NathalieAlomari-ai/AMR-Warehouse-System/ros2_ws/frames_2026-06-13_13.51.03.pdf

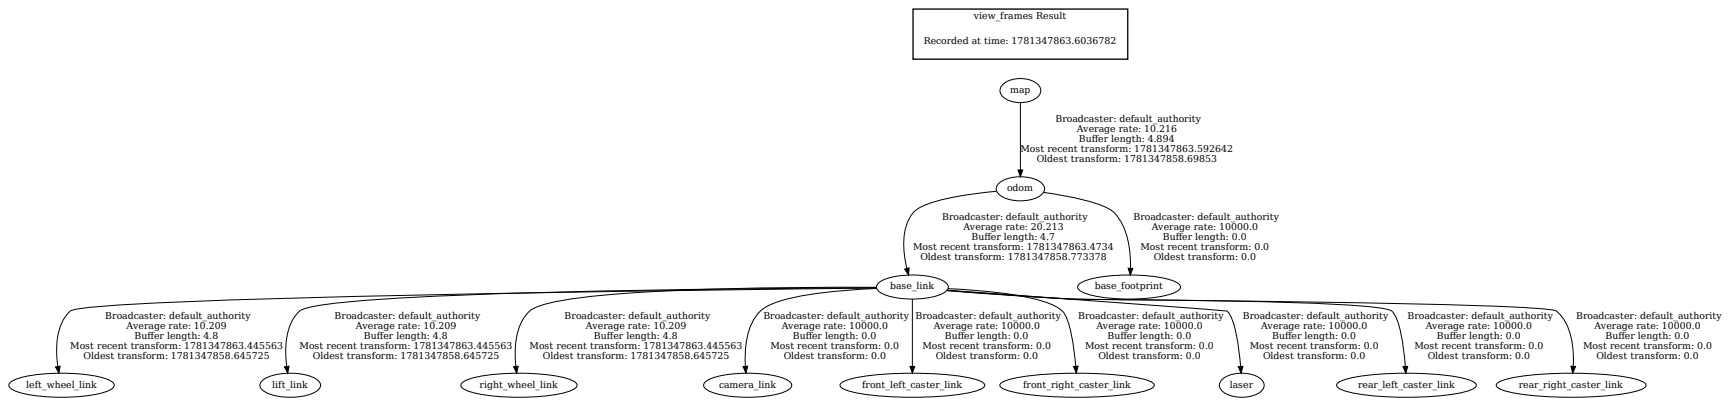
[picture p1: page 1]
view_frames Result; map; odom; Broadcaster: default_authority Average rate: 10.216 Buffer length: 4.894; base_link; Broadcaster: default_authority Average rate: 20.213 Buffer length: 4.7; base_footprint; left_wheel_link; Broadcaster: default_authority Average rate: 10.209 Buffer length: 4.8; lift_link; right_wheel_link; camera_link; front_left_caster_link; front_right_caster_link; laser; rear_left_caster_link; rear_right_caster_link

Recorded at time: 1781347863.6036782

Most recent transform: 1781347863.592642
Oldest transform: 1781347858.69853

Broadcaster: default_authority
Average rate: 10000.0
Buffer length: 0.0
Most recent transform: 0.0
Oldest transform: 0.0

Most recent transform: 1781347863.4734
Oldest transform: 1781347858.773378

Most recent transform: 1781347863.445563
Oldest transform: 1781347858.645725
