NathalieAlomari-ai/AMR-Warehouse-System/ros2_ws/src/amr_navigation/config/mapper_params_online_async.yaml

slam_toolbox:
  ros__parameters:

    # -----------------------------------------------------------------
    # Frames  — must match the URDF link names
    # -----------------------------------------------------------------
    odom_frame:  odom
    map_frame:   map
    base_frame:  base_footprint
    scan_topic:  /scan

    # -----------------------------------------------------------------
    # Mode
    # -----------------------------------------------------------------
    mode:         mapping
    use_sim_time: false

    # -----------------------------------------------------------------
    # Map update / TF
    # -----------------------------------------------------------------
    debug_logging:            false
    throttle_scans:           1
    transform_publish_period: 0.02   # seconds; 0 = never
    map_update_interval:      5.0    # seconds between full map updates
    resolution:               0.05   # metres per cell
    minimum_laser_range:      0.15   # metres — SLLIDAR C1 min range is 0.1 m
    max_laser_range:          12.0   # metres — SLLIDAR C1 max range
    minimum_time_interval:    0.1
    transform_timeout:        0.2
    tf_buffer_duration:       30.0
    stack_size_to_use:        40000000
    enable_interactive_mode:  true

    # -----------------------------------------------------------------
    # Scan matching
    # -----------------------------------------------------------------
    use_scan_matching:               true
    use_scan_barycenter:             true
    minimum_travel_distance:         0.1
    minimum_travel_heading:          0.1
    scan_buffer_size:                10
    scan_buffer_maximum_scan_distance: 10.0
    link_match_minimum_response_fine:  0.1
    link_scan_maximum_distance:        1.5
    loop_search_maximum_distance:      3.0
    do_loop_closing:                   true
    loop_match_minimum_chain_size:     10
    loop_match_maximum_variance_coarse:   3.0
    loop_match_minimum_response_coarse:   0.35
    loop_match_minimum_response_fine:     0.45

    # -----------------------------------------------------------------
    # Correlation search (translation)
    # -----------------------------------------------------------------
    correlation_search_space_dimension:       0.5
    correlation_search_space_resolution:      0.01
    correlation_search_space_smear_deviation: 0.1

    # -----------------------------------------------------------------
    # Correlation search (loop closure)
    # -----------------------------------------------------------------
    loop_search_space_dimension:       8.0
    loop_search_space_resolution:      0.05
    loop_search_space_smear_deviation: 0.03

    # -----------------------------------------------------------------
    # Scan matcher penalties
    # -----------------------------------------------------------------
    distance_variance_penalty:  0.5
    angle_variance_penalty:     1.0
    fine_search_angle_offset:   0.00349   # ~0.2 deg
    coarse_search_angle_offset: 0.349     # ~20 deg
    coarse_angle_resolution:    0.0349    # ~2 deg
    minimum_angle_penalty:      0.9
    minimum_distance_penalty:   0.5
    use_response_expansion:     true
