NathalieAlomari-ai/AMR-Warehouse-System/(commit log)

2026-05-23 Add SLAM launch file
    [amr_robot.urdf.xacro]
2026-05-29 wheels testing open loop 40% (100 pwm)
2026-05-29 Update serial bridge node to read Odometry data for SLAM
2026-05-30 Added PID with ros2 linkage
2026-05-31 fixed imu address
2026-05-31 pid best values for no load <0.50,0.0>
2026-06-12 Add YOLOv8n Colab training notebook (Task 3)
    Full training notebook with:
    - GPU check, ultralytics install, Drive mount + dataset extraction
    - data.yaml path fix for Colab absolute paths
    - YOLOv8n fine-tuning with warehouse-specific augmentation
    (hsv_v=0.6 for dim lighting, degrees=5 for camera tilt)
    - Validation with per-class mAP50 breakdown
    - Test inference visualization
    - Auto-save best.pt to Drive + direct laptop download
2026-06-13 feat: migrate firmware source files to correct directory and integrate ROS 2 serial bridge
    [Config.h, DriveSystem.h, MotorController.h, MotorDriver.h, PIDController.h, main.cpp, serial_bridge_node.py]
2026-06-13 refactor: reorganize project structure into modules (bringup, description, navigation, hardware) and integrate slam_toolbox
    [amr_robot.urdf.xacro]
2026-06-13 fix: align frame_id to 'laser' across launch and URDF
    [amr_robot.urdf.xacro]
2026-06-13 fix: set robot joints to fixed for stable presentation mode
    [amr_robot.urdf.xacro]
2026-06-13 fix: align serial bridge with firmware V-packet protocol
    [serial_bridge_node.py]
2026-06-13 Add full modular vision pipeline (Tasks 4, 5, 9)
    Modules added to amr_vision/:
    - camera_utils.py : AstraCamera wrapper (OpenNI2 + OpenCV)
    - depth_utils.py : DepthSampler (10x10 patch avg + rolling median buffer)
    - qr_detector.py : YOLO + pyzbar QR with 5-frame confirm threshold
    - barcode_detector.py: YOLO + pyzbar barcode with SKU check + depth anchor
    - visual_servo.py : proportional controller with hysteresis (enter=10px, exit=25px)
    - vision_main.py : 3-stage state machine (STAGE_1->2->3->GRIP->DONE)
    - teensy_comm.py : ASCII serial protocol to Teensy 4.1
    Scripts:
    - test_model.py: quick sanity check for best.pt on Astra Pro RGB stream
    Each module has a standalone __main__ t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
2026-06-14 Add box_detector.py and two-phase servo alignment in Stage 3
    - box_detector.py: detects class 0 (cardboard box) with depth sampling
    over a 20px patch for stable distance readings
    - vision_main.py Stage 3 updated:
    COARSE phase: box centre as servo anchor (large, visible when misaligned)
    FINE phase: barcode centre as anchor once box roughly centred
    Aligned only declared when barcode is the anchor (precise) + offset < 10px
    This solves the problem of barcode being too small to detect reliably
    when the robot is far or laterally misaligned.
    [box_detector.py, vision_main.py]
2026-06-16 Replace barcode with QR for Stage 2+3 FINE alignment; lower box confidence to 0.25
    [box_detector.py, vision_main.py]
2026-06-19 Fix: motor polarity, odometry ticks_per_rev, and TF frame tree
    [amr_robot.urdf.xacro]
2026-06-19 fix: harden serial telemetry parsing against corrupted lines
    Add header and field-count guards so garbled packets (e.g. from
    noisy USB-serial) are dropped before any type conversion. Move
    the fields dict build inside the try-except and broaden the handler
    to Exception so no parse error can propagate to the caller.
    [serial_bridge_node.py]
2026-06-21 trying pid with abdualla
2026-06-21 Fix: Calibrate encoder PPR to 2700 and fine-tune PID gains for stable differential drive
    [Config.h, DriveSystem.h, MotorController.h, PIDController.h, serial_bridge_node.py]
2026-06-22 fix: Configure BNO055 to IMUPLUS mode and update encoder PPR to 2700
    [Config.h]
2026-06-22 fix the serial brridge node
    [serial_bridge_node.py]
2026-06-22 fix number 2 is serial bridge
    [serial_bridge_node.py]
2026-06-23 fix the 2700 in ros2
    [amr_robot.urdf.xacro]
2026-06-23 fix: update PID VEL_KI to 1.0 to eliminate steady-state error
    [Config.h, main.cpp, mapper_params_online_async.yaml]
2026-06-23 fix: remove 180° yaw rotation from base_footprint_joint
    The rpy="0 0 3.14159" was flipping the robot 180° causing it to appear
    moving backward in RViz while physically moving forward.
    Claude-Session: https://claude.ai/code/session_01398Y6ZFw1hy4skUhHrX21f
    [amr_robot.urdf.xacro]
2026-06-23 fix: change wheel joints from fixed to continuous for live odometry
    Wheels were defined as fixed joints (presentation mode), preventing
    ROS from tracking wheel rotation. Now continuous with Y-axis rotation
    so encoder odometry and SLAM work correctly on real hardware.
    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
    [amr_robot.urdf.xacro]
2026-06-23 fix: add joint_state_publisher to bringup for continuous wheel joints
    Wheel joints changed to continuous require joint state messages for
    robot_state_publisher to broadcast their TF frames. Without this node
    the TF tree was incomplete causing warnings that could affect SLAM.
    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
2026-06-24 fix: move lidar and camera to rear of robot base_link
    Relocate laser joint from X=+0.25 to X=-0.25 and camera joint from
    X=+0.32 to X=-0.32, rotating camera 180° to face rearward (-X).
    [amr_robot.urdf.xacro]
2026-06-25 fix: close the velocity control loop using encoder PID feedback
    MotorController was open-loop — both motors received identical PWM
    regardless of actual speed, causing the robot to veer after ~2 s due
    to per-motor friction and back-EMF differences.
    Now update() reads the encoder every 20 ms, computes RPM, and runs
    PIDController (Kp/Ki from Config.h) to correct PWM until actual RPM
    matches the target. The integrator resets on stop to prevent windup
    carrying into the next move.
    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
    [MotorController.h]
2026-06-25 fix: swap left encoder pins to match forward=positive convention
    Left encoder was reading negative RPM while moving forward, causing
    the closed-loop PID to fight itself (setpoint=+50, actual=-50,
    error=+100 → diverges). Swapping pins 22/23 makes both encoders
    read positive when the robot moves forward, consistent with the
    positive RPM commands sent by serial_bridge_node.
    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
    [main.cpp]
2026-06-25 fix: add motor inversion, feed-forward, and correct odometry sign
    Four bugs on this branch were causing the robot to veer / fail to drive:
    1. Left motor drove backward: the encoder pin swap (23,22) fixed the encoder
    reading direction but setSpeed(+duty) still activated RPWM = backward for
    the left BTS7960. Added motorInverted=true so duty is negated before
    setSpeed(), activating LPWM = left forward.
    2. No feed-forward: PIDController was pure P+I+D → duty with no baseline.
    Without FF the integrator had to wind up from zero before the motor moved,
    and VEL_ICLAMP=200 wound up so high that stopping failed (integral fought
    the deceleration ramp). Added ffDuty = targetRPM/m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
    [Config.h, MotorController.h, main.cpp, serial_bridge_node.py]
2026-06-25 fix: normalise left encoder delta and encoder count in firmware
    The encoder pin swap (23,22) did not reverse the raw count direction —
    left encoder still increments negative for forward motion on real hardware.
    Without delta normalisation the PID saw target=+80, actual=-128 → error=+208
    → max duty, making the left motor run at free-run max (~130 RPM) while
    the right motor was PID-controlled to 78 RPM. The robot veered hard left.
    Changes:
    - inverted flag now negates rawDelta before PID and telem accumulation,
    so _actualRPM and _telemRPM are +positive for forward on both motors.
    - getEncoderCount() returns -_lastCount when inverted so DriveSystem's
    simple (left + right) sum gives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
    [MotorController.h, main.cpp]
2026-06-25 feat(web_app): add Navixa dashboard + landing page + skills
    [angular.csv, app-interface.csv, astro.csv, charts.csv, colors.csv, design.csv, draft.csv, flutter.csv]
2026-06-25 final code fixed with robot moving in stright line
    [Config.h, MotorController.h, main.cpp]
2026-06-25 fix: serial_bridge owns odom TF to fix slam_toolbox message filter timing
2026-06-25 fix: set minimum_laser_range 0.15m and transform_timeout 0.5s for SLLIDAR C1
    [mapper_params_online_async.yaml]
2026-06-28 dark mode + removing sutitle in home + rename lidar
2026-06-29 feat: wire up Nav2 autonomous navigation bringup
2026-06-30 Jetson migration: config.py platform detection, QR multi-decode, servo rate limiting
2026-07-01 feat: add waypoint saver and navigator scripts for warehouse missions
    - waypoint_saver.py: saves current AMCL pose as a named waypoint to waypoints.yaml
    - waypoint_navigator.py: sends robot to any named waypoint via Nav2 action
    - waypoints.yaml: empty waypoints config, populated by waypoint_saver
    - CMakeLists: install scripts to lib/ so ros2 run works
    - package.xml: add rclpy, nav2_msgs, geometry_msgs dependencies
2026-07-02 fix: flip drive direction so LiDAR side is robot front
    - URDF: rotate base_footprint_joint 180 deg around Z so LiDAR appears at +X
    - serial_bridge: add flip_drive_direction param; negates linear cmd to Teensy
    and negates measured vx so forward = LiDAR-first throughout the stack
    - bringup: enable flip_drive_direction=True for physical robot
    This fixes backwards navigation in Nav2 and removes the zig-zag caused
    by the 180-degree frame mismatch between URDF and physical robot.
    [amr_robot.urdf.xacro]
2026-07-02 fix: correct URDF wheel/caster positions to match physical robot layout
    After the 180-degree base_footprint flip, wheel_x must be positive so
    drive wheels appear behind centre (toward caster/back side) in RViz.
    Rear casters repositioned to x=+0.10 so all 4 casters appear at the
    back of the robot in the flipped frame, matching physical hardware.
    [amr_robot.urdf.xacro]
2026-07-05 Allow DWB to command reverse velocity so robot can back out of blocked spots
2026-07-05 Tighten inflation radius/scaling to stop DWB refusing narrow aisles
2026-07-05 Fix MQTT topics to match web app contract (amr/status, amr/orders)
    [mqtt_publisher.py, vision_main.py]
2026-07-07 Add aux-hardware bridge, mission coordinator, and vision stub
    Integrate lift/stepper/pump/vision onto the single Teensy via one serial
    owner. serial_bridge_node gains /aux/command (verbatim passthrough) and
    /aux/status (routes Teensy EVT lines); odometry path untouched.
    New amr_coordinator package:
    - coordinator_node.py: plain async FSM sequencing the full pick-and-place
    mission (Nav2 -> shelf QR -> lift -> box QR + centering -> grip -> drop
    -> home), blocking on EVT acks, aborting to STOP on fault/timeout.
    - vision_stub.py: answers /vision/request and streams SERVO so the mission
    runs without the YOLO camera pipeline.
    Hand-off docs for the firmware port (pin map + non-blocking parse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
2026-07-07 Add lift control to the unified integration firmware
    Ports the bench-tested linear actuator onto the same Teensy 4.1 that
    runs drive PID + odometry, since serial_bridge_node requires a single
    serial owner. Implements LIFT <mm>/STOP per docs/HANDOFF_zahra_firmware.md,
    tracking estimated position by delta rather than absolute duration so
    repeated partial moves (e.g. 200 -> 0 -> 120) don't mis-time. Only a
    bottom re-homing switch is wired — the top limit switch was dropped
    after bench-verifying full-range timing on the assembled scissor lift.
    Stepper carriage and vacuum pump are intentionally not ported yet.
2026-07-09 Calibrate lift actuator speed/travel from bench tests (integration: wheels + linear actuator only, no upper mechanism yet)
    Bench-measured the assembled scissor lift under its ~10kg working load
    and corrected several bad assumptions in the open-loop lift timing:
    - True actuator rod travel is 0-444mm, not the originally assumed 500mm
    (confirmed by running the bare actuator off a power supply). Lowered
    LIFT_MAX_TRAVEL_MM to 434mm (10mm margin, no hardware backup since
    there's no top switch).
    - Split the single ACTUATOR_SPEED_MM_S into direction-specific
    ACTUATOR_EXTEND_SPEED_MM_S / ACTUATOR_RETRACT_SPEED_MM_S, since the
    load makes retracting (gravity-assisted) faster than extending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
    [Config.h, LiftControl.h]
2026-07-09 integration node with natalie and zahra command + smooth centering for my part + cmd_vel remove accidental web_app/skills tree
    [angular.csv, app-interface.csv, astro.csv, charts.csv, colors.csv, design.csv, draft.csv, flutter.csv]
2026-07-11 Pull Abdalla's real vision package to replace the integration stub
    Replaces the placeholder pretrained.py/visualloop.py with the actual
    QR/barcode/box detection pipeline from abdalla-vision-branch, including
    the ROS-based teensy_comm.py (publishes to /aux/command instead of
    opening serial directly, per docs/HANDOFF_abdalla_vision.md) so it can
    run alongside serial_bridge_node on the integrated robot.
    [barcode_detector.py, box_detector.py, camera_utils.py, config.py, depth_utils.py, mqtt_publisher.py, qr_detector.py]
2026-07-11 Detect --break-system-packages support in setup_jetson.sh instead of assuming it
    pip 22.0.2 (stock on Ubuntu 22.04, confirmed on the Jetson) predates
    PEP 668 and doesn't recognize --break-system-packages at all -- passing
    it made every pip3 install call in the script fail outright. Only add
    the flag when the installed pip actually supports it.
2026-07-11 Fix setup_jetson.sh: no prebuilt Jetson torchvision, and pip clobbers torch
    Two real bugs found while deploying to the Jetson:
    1. NVIDIA doesn't publish a prebuilt torchvision wheel for Jetson (only
    pytorch/ and tensorflow/ exist under their v## redist folders) --
    torchvision has to be built from source against the installed torch
    build. Document that step, including the gotcha that verifying it
    must happen from outside the source checkout dir (Python otherwise
    shadows the installed package with the uncompiled source tree).
    2. `pip install -r requirements.txt` was letting pip "resolve"
    ultralytics' unpinned `torch>=1.8.0` dependency by silently
    uninstalling the correct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
2026-07-11 Pull Abdalla's mqtt_bridge node for the web dashboard
    Cherry-picked from abdalla-vision-branch (de3d364a673ccd8de649870301846c8ab24ee6b9),
    scoped to just this commit so it doesn't pull in his branch's stale
    setup_jetson.sh over our fixed version.
    Bridges the integrated ROS2 mission to the web dashboard over MQTT:
    watches /mission/state (or infers from /vision/request, /aux/command,
    /cmd_vel) and publishes amr/status, and turns dashboard PICK/STOP
    orders into /mission/start and /aux/command STOP. Self-contained in
    amr_vision, no changes required to the coordinator or other nodes.
    [mqtt_bridge.py, mqtt_publisher.py]
2026-07-12 Add full power/wiring guide and fix stale stepper pin docs
    README's pin map and wiring checklist still referenced the pre-remap
    stepper/relay pins (26/27, 24/25) instead of the actual 36/37/40/41 in
    Config.h. Also adds a full connection guide: power architecture, thick vs
    thin wire gauges by circuit, common grounding, TB6600 DIP switch tables
    (current + microstep), and the common-cathode signal wiring this board
    uses. Code comments in Config.h/StepperControl.h/main.cpp now point to it.
    [Config.h, StepperControl.h, main.cpp]
2026-07-13 camera_utils: fall back to RGB-only when the depth stream can't open
2026-07-13 camera: add DEPTH_ENABLED switch to skip OpenNI2 (avoids segfault when depth sensor unpowered)
    [camera_utils.py, config.py]
2026-07-14 Add headless live_qr_test.py for on-Jetson camera+QR verification
2026-07-17 Fix BOX_QR centring fighting Nav2: route vision through twist_mux (cmd_vel_vision, prio 50)
    [vision_node.py]
2026-07-17 web_app: update team roles (Abdalla: Battery + Vision & Software; Zahra: Lifting & Suction Subsystem)
2026-07-17 Fix drive wheel direction bugs: left encoder A/B swap and right motor polarity
    Bench testing traced the robot rotating in place instead of driving straight
    to two independent wiring issues, not a PID tuning problem:
    - Left encoder was wired A=23/B=22, counting backward; corrected to A=22/B=23
    in the Encoder constructor.
    - Right BTS7960 has RPWM wired as reverse (not forward as originally assumed)
    -- confirmed by watching the right wheel visibly spin backward under a
    positive target. Set motorInverted=true for rightMotor to match, same as
    the already-correct left side.
    Updated README.md pin map and wiring guide to match the corrected wiring.
    [main.cpp]
2026-07-17 Speed up stepper carriage after fixing homing/extend/retract stall margin
    Homing speed (400->1200 SPS) and normal move speed (3200->4200 SPS) raised
    for faster cycle time. Acceleration raised alongside (2400->4200 steps/s^2)
    to keep the same limit-switch stopping distance at the higher cruise speed --
    without it, stop() decelerates over a much longer distance (scales with
    speed^2), so the carriage kept coasting well past the switch instead of
    stopping promptly.
    [Config.h]
2026-07-18 Add laser box filter to drop scissor-lift pillars from /scan
2026-07-18 Fix empty /scan: run chassis box filter in laser frame (no TF dependency)
    [main.cpp]
2026-07-18 Fix serial_bridge ticks_per_rev 1000->2700 to match firmware ENCODER_PPR
    [serial_bridge_node.py]
2026-07-18 Fix TF ownership: EKF owns odom->base_footprint (fused IMU yaw), not serial_bridge
    serial_bridge was publishing a raw wheel-odometry TF (unreliable encoder
    yaw) while the EKF's TF was disabled, discarding the IMU heading fusion.
    AMCL drifted/lost the map on every rotation. Now matches ekf.yaml design.
2026-07-18 Revert serial_bridge ticks_per_rev 2700->1000
    [serial_bridge_node.py]
2026-07-18 fix: restore EKF ownership of odom->base_footprint TF
    Commit 34da2b9 handed the odom->base_footprint transform to
    serial_bridge_node (raw encoder odometry) to silence a slam_toolbox
    message-filter timing warning. This bypassed the EKF, so Nav2/AMCL
    localized off encoder-only heading, which is documented-unreliable
    (gearbox backlash/slip). The result: robot pose drifts/spins in the
    map and AMCL gets lost when navigating to a goal.
    Restore the intended design (matching every comment in bringup.launch.py
    and ekf.yaml): serial_bridge publish_tf=False, ekf_node publish_tf=True,
    so the IMU-fused heading drives the transform Nav2 depends on.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
2026-07-18 fix: correct ticks_per_rev 1000->2700 to match firmware ENCODER_PPR
    serial_bridge_node used ticks_per_rev=1000 while the Teensy firmware
    (Config.h) counts ENCODER_PPR=2700 per rev. This scales the left-wheel
    L_RPM fallback (used when firmware reports RPM=0 while the encoder is
    still ticking, e.g. at low speed near obstacles) by 2.7x, injecting a
    phantom left-wheel velocity. Since yaw is derived from (v_right-v_left),
    this produces spurious rotation in the encoder odometry and contributes
    to the robot drifting/getting lost during navigation.
    The slam-setup branch already carried this fix ('fix the 2700 in ros2');
    system-integration was missing it.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
2026-07-18 fix: disable flip_drive_direction now that firmware fixes motor polarity in HW
    With the corrected 'integration' firmware flashed (right BTS7960
    motorInverted=true, left encoder swapped), the right motor now drives
    the correct direction in hardware. The ROS-side flip_drive_direction=True
    was a software band-aid for the OLD firmware's reversed right motor;
    with the HW fix in place it becomes a second inversion, so teleop
    forward ('i') drove the robot backward. Disable it: +linear.x now
    drives toward the LiDAR front, consistent with the URDF laser at +X.
2026-07-18 fix: flip_drive_direction True — physical motion was opposite to odometry
    Teleop showed the robot driving physically backward on 'i' (forward)
    while RViz/odometry showed forward: the drive command and the reported
    odometry vx were both opposite to the robot's true motion. Setting
    flip_drive_direction=True inverts BOTH the motor command and the
    reported vx together, so +linear.x drives the robot physically forward
    (toward the LiDAR front) AND odometry reports forward — RViz and reality
    now agree, which is required for Nav2 to drive toward goals correctly.
2026-07-18 final integration without stepper fix (imu + wheels fixed)
    Reverts the stepper speed bump (STEPPER_MAX_SPEED_SPS/HOMING_SPEED_SPS/
    ACCELERATION back to 3200/400/2400) introduced after 5a33816 — not
    bench-verified yet, kept out of this build on purpose.
    Keeps everything else at the current tip: the left-encoder A/B swap
    (leftEnc(22,23)) and the rightMotor motorInverted=true fix, both of
    which were verified working on hardware — heading now tracks correctly
    during physical rotation instead of staying frozen at 0.
    [Config.h]
2026-07-18 feat: add laser box filter (mask lift pillars) on top of working code
    Restores the chassis box filter needed for the scissor-lift: sllidar now
    publishes /scan_raw, scan_to_scan_filter_chain drops returns inside the
    lift footprint and republishes the clean /scan that AMCL and the costmaps
    consume. Based on the working 9a16371 (EKF-owns-TF, ticks_per_rev=2700).
2026-07-18 fix: flip_drive_direction=False to match flashed firmware (1577654)
    The integration firmware fixes drive direction in hardware (both motors
    inverted + left encoder swap), so +cmd already = forward. The ROS flip
    was a band-aid for the old firmware; with the fix flashed it double-
    inverted (robot drove backward for 'i'). Set False so real-world and
    RViz agree.
2026-07-18 fix: decouple odometry sign from drive direction so Nav2 drives toward goals
    After re-flashing the Teensy to fix motor polarity (flip_drive_direction=False),
    the robot drove correctly under teleop but the wrong way under Nav2. The single
    flip_drive_direction flag controlled both the outgoing drive command and the
    odometry vx sign, so disabling it to fix the drive also disabled the encoder
    sign correction. The encoders still report negative RPM for forward motion, so
    /wheel/odometry published vx with the wrong sign; the EKF trusts vx as its
    primary linear input, making Nav2 believe forward commands moved the robot
    backward and reverse them.
    Add a separate flip_odom_direction parameter that n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
    [serial_bridge_node.py]
2026-07-18 docs: add full per-subsystem testing command reference
    Consolidates the commands needed to test each part of the AMR stack
    individually and then end-to-end: vision (camera/QR), aux hardware
    (lift/stepper/pump), drive/odometry/IMU, LiDAR, Nav2+AMCL+RViz, SLAM,
    MQTT+dashboard, and the coordinator mission. Interfaces (topics, message
    types, params, firmware command vocabulary) verified against the
    feature/system-integration sources.
    Claude-Session: https://claude.ai/code/session_01YbRxd7ZoUVJzaV4J4JtgRB
2026-07-18 docs: link testing command reference and doc index from README
    Adds a Testing & Documentation section pointing to TESTING_COMMANDS.md
    and the other run/vision/MQTT/waypoint/SLAM guides, and notes the shared
    ROS_DOMAIN_ID=30 convention for Jetson + laptop.
    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
2026-07-19 fix: set flip_odom_direction=False after hardware verification
    On-robot measurement showed /wheel/odometry reports POSITIVE vx for forward
    motion already — the re-flashed firmware has the correct encoder sign. The
    previous flip_odom_direction=True inverted a correct value, making odometry
    report backward motion while the robot drove forward, which slid the pose
    backward in RViz and diverged AMCL ("robot gets lost").
    Set flip_odom_direction=False so odom vx stays positive for forward motion and
    localization stays consistent. The decoupled flip_odom_direction knob is kept
    (now a no-op) so drive and odometry signs remain independently correctable.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
2026-07-19 fix: invert IMU yaw sign so heading matches ROS CCW convention
    On-robot measurement: turning left (CCW), the IMU /imu/data angular_velocity.z
    read negative while the wheel-odometry angular.z read positive. The BNO055
    reports a compass-style heading that increases clockwise, opposite to the ROS
    REP-103 convention (CCW = positive yaw). This mirrored every turn left/right in
    RViz and made the IMU yaw-rate disagree with the wheel odometry, confusing the
    EKF.
    Add an invert_imu_yaw parameter that negates the IMU heading at the source;
    negating the heading corrects both the orientation quaternion and the
    differentiated yaw-rate together. Enabled in bringup for this robot's BNO055
    mounting.
    Co-Aut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
    [serial_bridge_node.py]
